daviddurkins/4AirPollutantSensors/4 airpollutant sensor schematic.JPG

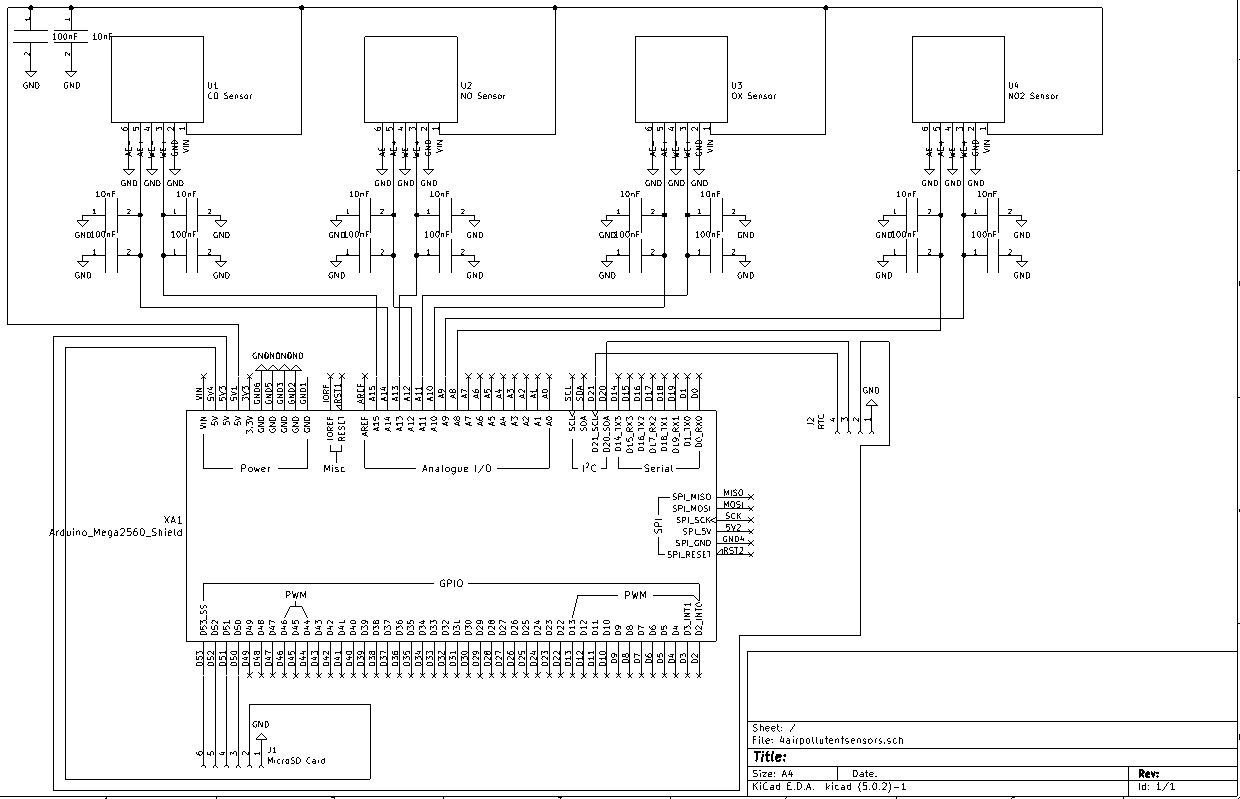
4 airpollutant sensor schematic.JPG
