daviddurkins/4AirPollutantSensors/4 airpollutants pcb.JPG

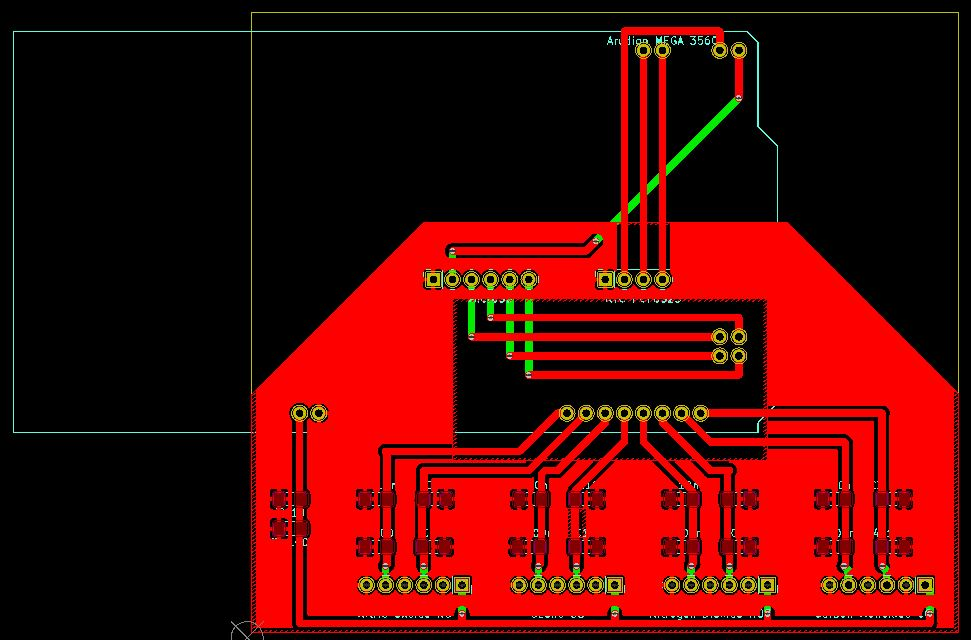
4 airpollutants pcb.JPG
